ODZ-UJF-AV-CR/QFHBAL01/hw/cam_profi/QFHBAL01-F_Cu.dxf

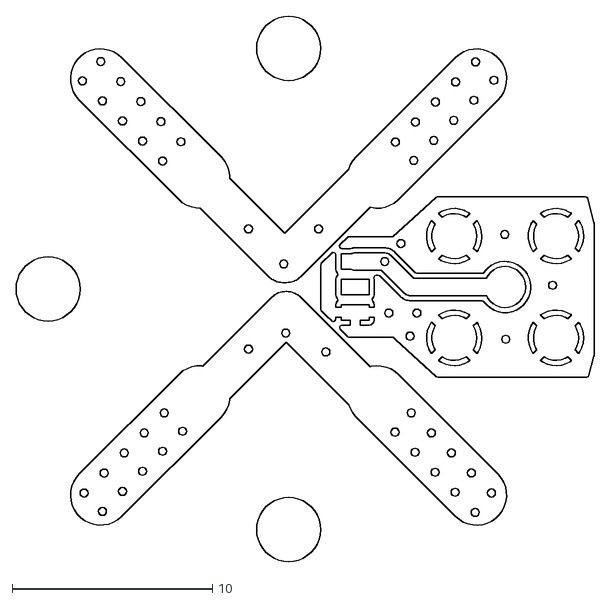
[picture p3: CAD file, 2020-11-24]
hw/cam_profi/QFHBAL01-F_Cu.dxf
28.8 x 27.2
