ODZ-UJF-AV-CR/QFHBAL01/hw/cam_profi/QFHBAL01-User_Comments.dxf

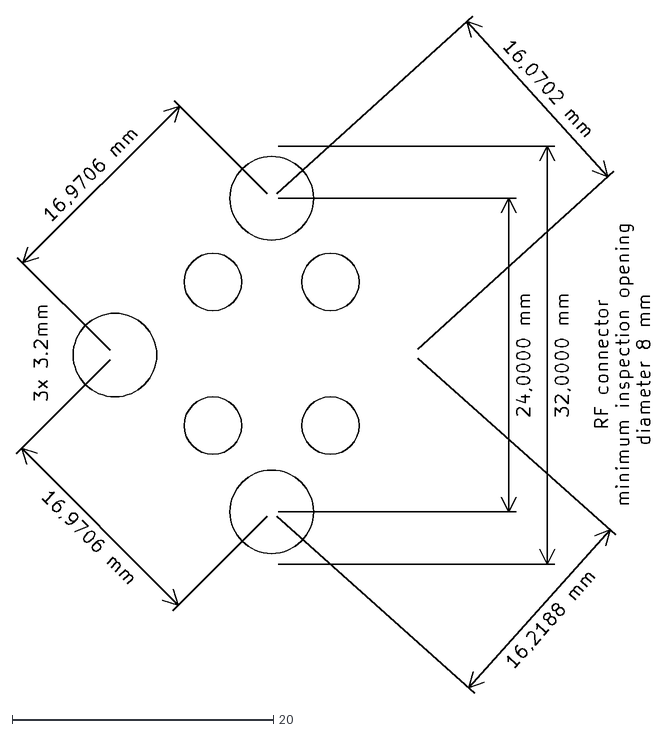
[picture p4: CAD file, 2020-11-24]
hw/cam_profi/QFHBAL01-User_Comments.dxf
48.5 x 51.8
