ODZ-UJF-AV-CR/QFHBAL01/hw/cam_profi/QFHBAL01-Edge_Cuts.dxf

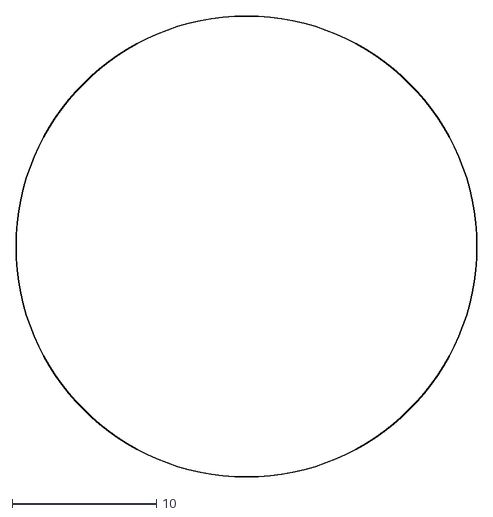
[picture p5: CAD file, 2020-11-24]
hw/cam_profi/QFHBAL01-Edge_Cuts.dxf
32.0 x 32.0
