ODZ-UJF-AV-CR/QFHBAL01/(list of files, cad)

Other CAD files:
hw/cam_profi/QFHBAL01-F_Mask.dxf
hw/cam_profi/QFHBAL01-F_Silkscreen.dxf
