ODZ-UJF-AV-CR/QFHBAL01/(threads)

Thread 3 (2020-10-27):

Rozměry PCB

kaklik, 2020-10-27:
Tak sem si aktuální plošný spoj zkusil okótovat.

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

Výsledkem je zjištění, že plošný spoj je větší, než průměr antény na 868 MHz, který je asi 57 mm.

Plošný spoj tak úplně nerespektuje [původní plán použití](https://github.com/cernohorsky/QFH-Antenna-868MHz/issues/1), jak tak zřejmě nutné jej zmenšit.

roman-dvorak, 2020-10-27:
Nemohl by mít tvar nějakého osmiúhelníku?

kaklik, 2020-10-27:
> Nemohl by mít tvar nějakého osmiúhelníku?

To nevyřeší celkovou velikost.. Ale když bude jinej než pravoúhlej, tak pak už může být klidně i kulatý. Protože jde už jen o rozdíl dělení drážkováním a dělení frézováním.

Closed 2020-10-28.

Thread 5 (2020-11-07):

Kontrola DRC

ChroustJan, 2020-11-07:
Mě DRC kontrola ukazuje takovouto šílenos:
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

Chtělo by provést nějakou optimalizaci, aby se nezanedbala nějaká důležitá chyba.

kaklik, 2020-11-09:
Tak jsem zjistil, že ty potíže jsou z velký části způsobený tímhle:

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

@cernohorsky  z nějakého důvodu dal do každého výstupu dvě plošky, které jsou THT a jsou nad sebou. Důsledkem pak je, že DRC si pak takhle stěžuje. Redundantní plošky jsem odstranil.

DRC pak zdá se dobře nefunguje na kulatém PCB a vytváří mnoho zřejmě falešných hlášek tohoto typu:

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

Další problematická hláška je unconnected vias. Která vzniká v případě, že se do plošky dají vias, které ale nemají připojený žádný net.

V obou těchto případech jde buď o chybu kicadu a nebo o velmi specifické použití. Takže jsem tyto dvě chyby v DRC zakázal.
Výsledkem je, že si DRC už na žádné další chyby nestěžuje.

ChroustJan, 2020-11-10:
Odesláno do výroby.

Closed 2020-11-10.

Thread 6 (2020-11-10):

QFHBAL01 osadit MCX konektorem

kaklik, 2020-11-10:
Moduly je možné osadit bez RF konektoru, ten klidně naletuju sám.  Je ale potřeba minimálně pro 3ks mít MCX konektor jak na kabel RG-174, tak i do PCB.

ChroustJan, 2020-11-10:
@kaklik  dle seznamu vyrobím 6ks bez konektoru.

kaklik, 2020-11-20:
Tohle se stalo redundantním k https://github.com/ODZ-UJF-AV-CR/FIK-6/issues/13

Closed 2020-11-20.

Thread 7 (2020-11-18):

Zvětšit písmo

ChroustJan, 2020-11-18:
Zvážit, zda není možné provést zvětšení písma. Písmo pod touto hodnotou: Width 1,3 mm, Height 1,3mm, Thickness 0,3mm již není úplně ideálně čitelné a hezké.

kaklik, 2020-11-18:
Nebylo by prosím možné k tomu připojit nějakou fotografii?

ChroustJan, 2020-11-18:
@kaklik jaké parametry jsou na PCB?

ChroustJan, 2020-11-19:
A kde je v tabulce písmo vysoké 1mm? Oni tam dají co chceme, ale mě to přijde zbytečně malé, když je tam místo na větší popisky.
