ODZ-UJF-AV-CR/QFHBAL01/(commit log)

2020-10-25 First version.
    [QFHBAL01.kicad_pcb, QFHBAL01.sch]
2020-10-25 Solved issue #1: Layout upraven pro moznost zapojeni jako "common mode" a "trafo".
    [QFHBAL01.kicad_pcb, QFHBAL01.sch]
2020-10-27 Updated to the new version of KiCAD.
    [QFHBAL01.kicad_pcb, QFHBAL01.kicad_sch]
2020-10-27 Structure cleanup.
    [QFHBAL01.kicad_pcb, QFHBAL01.kicad_sch, QFHBAL01.sch]
2020-10-27 Removing old KiCAD files
    [QFHBAL01.sch]
2020-10-27 Dimensioning of the PCB.
    [QFHBAL01.kicad_pcb]
2020-10-27 Add diagonal dimension.
    [QFHBAL01.kicad_pcb]
2020-10-28 Solved #2 and #3
    [QFHBAL01.kicad_pcb]
2020-10-28 Changed PCB size to 32mm.
    [QFHBAL01.kicad_pcb]
2020-11-05 Mechanical improvement.
    Silkscreen clarification.
    [QFHBAL01.kicad_pcb, QFHBAL01.kicad_sch]
2020-11-06 Improve RF layout.
    [QFHBAL01.kicad_pcb]
2020-11-07 Úprava mezery masky.
    [QFHBAL01.kicad_pcb]
2020-11-09 Cleanup redundant pads.
    Disable board clearance and unconnected vias check.
    [QFHBAL01.kicad_pcb, QFHBAL01.kicad_sch]
2020-11-10 Příprava výrobních dat a generování výrobních dat
    [QFHBAL01-B_Cu.gbr, QFHBAL01-B_Mask.gbr, QFHBAL01-B_Silkscreen.gbr, QFHBAL01-Edge_Cuts.gbr, QFHBAL01-F_Cu.gbr, QFHBAL01-F_Mask.gbr, QFHBAL01-F_Silkscreen.gbr, QFHBAL01-NPTH.drl]
2020-11-22 Export image with dimensions.
    [QFHBAL01.kicad_pcb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]
2020-11-24 New dimensions.
    DXF file exported with proper origin.
    [QFHBAL01-Edge_Cuts.dxf, QFHBAL01-F_Cu.dxf, QFHBAL01-F_Mask.dxf, QFHBAL01-F_Silkscreen.dxf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]
2020-11-24 Improve dimensions size and units.
    https://github.com/ODZ-UJF-AV-CR/balon/issues/40
    [QFHBAL01-Edge_Cuts.dxf, QFHBAL01-F_Cu.dxf, QFHBAL01-F_Mask.dxf, QFHBAL01-F_Silkscreen.dxf, QFHBAL01-User_Comments.dxf]
2026-09-08 Enhance README with usage context and corrections
    Updated README to include usage context for QFH antennas on NPI stratospheric balloons and corrected 'silk screen' to 'silkscreen'.
